Ponderrawr/Christmas-Ornament-PCB/plates/README.md

# Front plates

| File | Description |
|---|---|
| `wreath_plate.stl` | Wreath plate for the 6 wreath LED positions (2.9 MB) |
| `Thickness_Test_Coupon.stl` | 0.4-3.2 mm step wedge for checking light transmission in your filament |

**Print:** face up, 0.12 mm layers, 100% infill, no supports unless you see sagging on the bow. See [docs/04-front-plates.md](../docs/04-front-plates.md) for filament choice.
