Ponderrawr/Christmas-Ornament-PCB/docs/images/wreath_plate_render.png

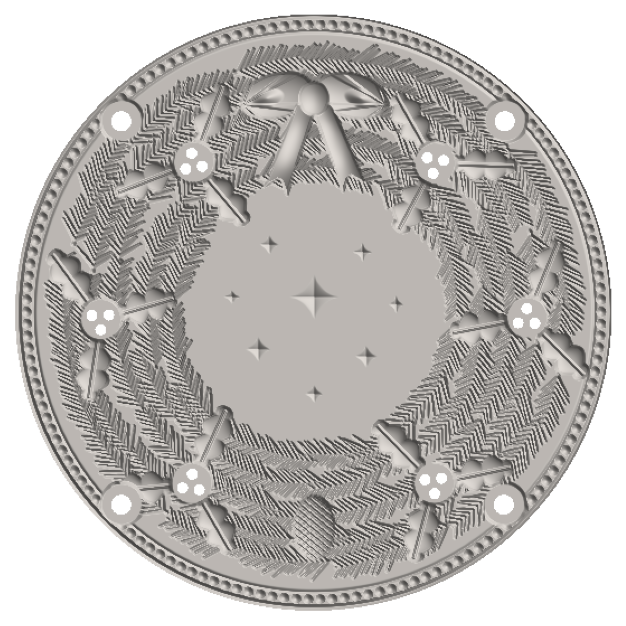
docs/images/wreath_plate_render.png
