Ponderrawr/Christmas-Ornament-PCB/plates/wreath_plate.STL

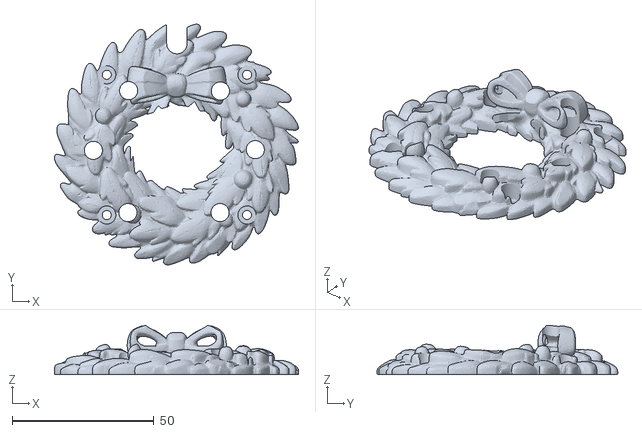
[picture p5: CAD file, 2026-11-04]
plates/wreath_plate.STL
86.1 x 85.0 x 17.4
