Ponderrawr/Christmas-Ornament-PCB/plates/Thickness_Test_Coupon.stl

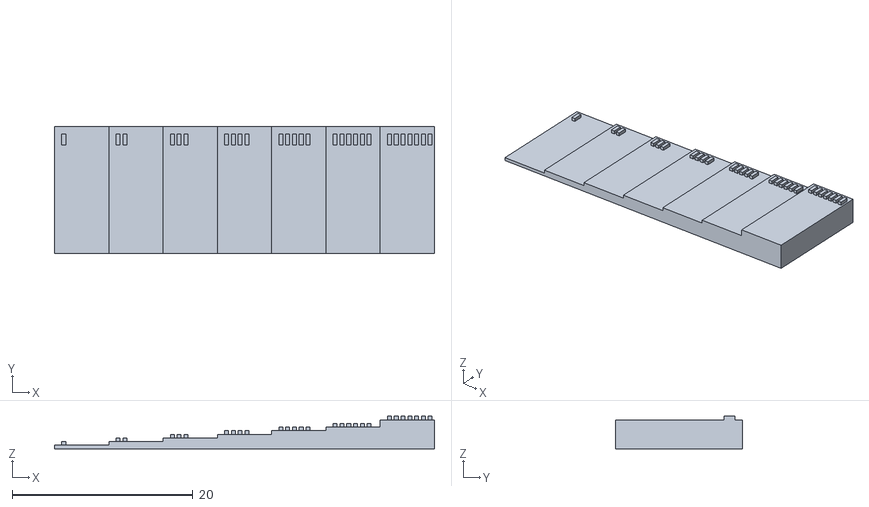
[picture p6: CAD file, 2026-10-31]
plates/Thickness_Test_Coupon.stl
42.0 x 14.0 x 3.60
