Ponderrawr/Christmas-Ornament-PCB/(commit log)

2026-10-31 Fix image filename case in README
    Corrected the case of the schematic image filename in the README.
2026-11-04 Delete docs/images/Schematic.png
    Duplicate Image
2026-11-04 Delete plates/generator/wreath_plate.py
    Obsolete
2026-11-04 Add files via upload
    Added wreath front plate STL file.
    [wreath_plate.STL]
2026-11-04 Revise printing instructions in README
    Updated printing instructions for better clarity on support usage.
2026-11-04 Update wreath_plate.stl file size in README
